CedarGroveStudios/DRV8830_FeatherWing_PCB/README.md

# DRV8830_FeatherWing_PCB

## A custom motor controller and power monitor FeatherWing using the DRV8830 motor controller and INA260 or INA271 power monitor.

[DRV8830 CircuitPython Driver Class Description](https://github.com/CedarGroveStudios/DRV8830_FeatherWing_PCB/blob/main/docs/pseudo%20readthedocs%20cedargrove_drv8830.pdf)

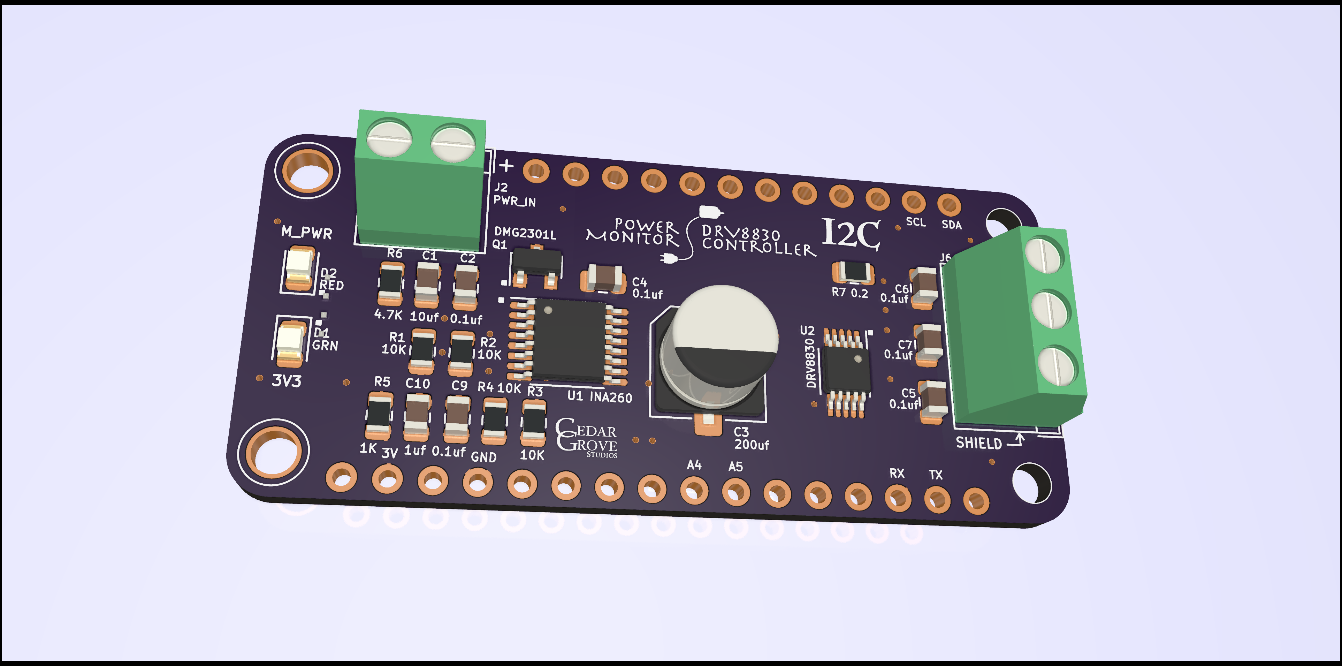
[picture p1: pcb_ina260/Motor_Tester_DRV8830_Wing_glam.png]
DRV8830 FeatherWing INA260


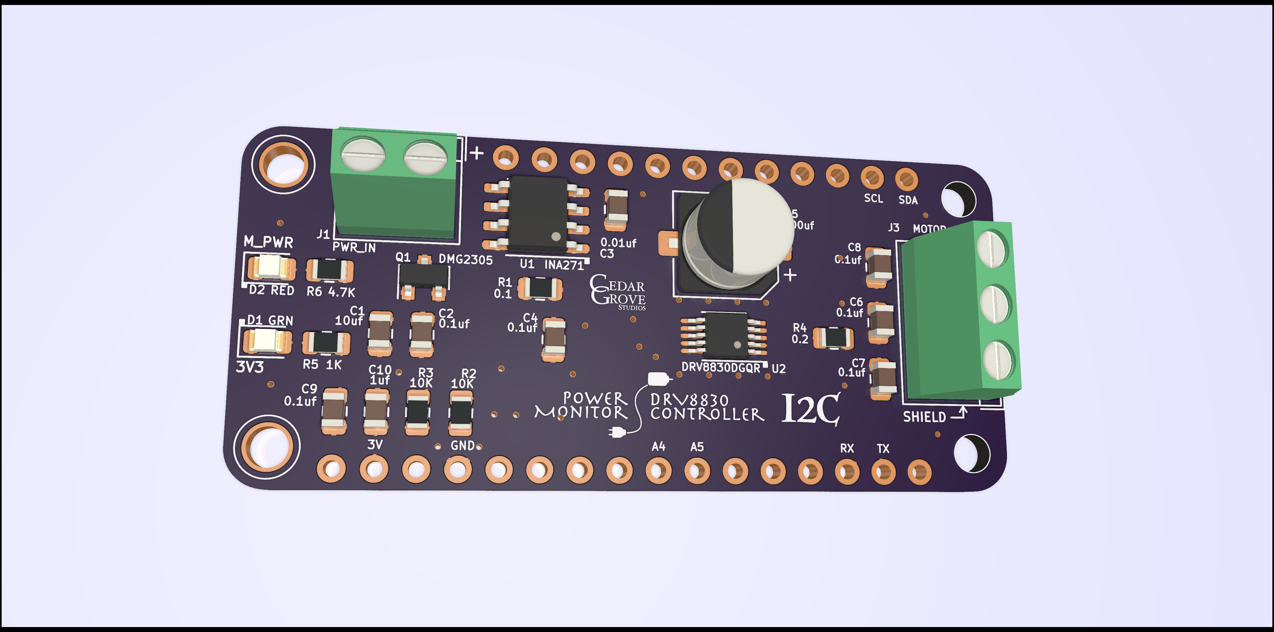
[picture p2: pcb_ina271/Motor_Tester_DRV8830_Wing_glam.png]
DRV8830 FeatherWing INA271
