CedarGroveStudios/DRV8830_FeatherWing_PCB/docs/pseudo_readthedocs_cedargrove_drv8830.pdf

## cedargrove_drv8830

A CircuitPython class for operating the Cedar Grove DRV8830 I2C Motor Controller FeatherWing.

The Cedar Grove DRV8830 FeatherWing is a custom board that integrates the DRV8830 I2C motor controller with an INA260 power monitor. The FeatherWing was designed for use by a DC motor testing apparatus, providing both motor control and the ability to measure motor power. The FeatherWing also provides a connection for an external RPM sensor.

- Author(s): JG for Cedar Grove Studios

## Implementation Notes

### Hardware: Software and Dependencies:

- Adafruit CircuitPython firmware for the supported boards: https://github.com/adafruit/circuitpython/releases

Class representing the Cedar Grove DRV8830, a DC motor driver with I2C interface. Using an internal PWM scheme, the DRV8830 produces a regulated output voltage from a normalized input value (-1.0 to +1.0) or voltage input value (-5.06 to +5.06 volts).

A class property.

A class property.

class cedargrove_drv8830.DRV8830(*, i2c_bus, address=0x2A)

Parameters: | • | i2c_bus – The I2C data and clock bus signals as defined in the host device’s board definition. Typical value is board.I2C() . No default value.
- address – The I2C bus address. Defaults to 0x2A (d42).

throttle

Parameters: | value – Change or read the numeric value of the motor speed, ranging from -1.0 (full speed reverse) to +1.0 (full speed forward), or None (controller off). If None, the H- bridge is set to high-impedance (coasting). If 0.0, the H-bridge is set to cause braking.

throttle_volts

Parameters: | value – Change or read the numeric value of the motor speed, ranging from -5.06 volts (full speed reverse) to +5.06 volts (full speed forward), or None (controller off). If None, the H-bridge is set to high-impedance (coasting). If 0.0, the H-bridge is set to cause braking.

© Copyright 2021 Cedar Grove Studios, Revision 0.1

A class property.

A class property.

Clears all fault condition flags.

bridge_control

Parameters: | (Read-Only) Motor driver bridge status. Returns the 2-bit bridge control integer value
and corresponding description string:
0b00 | STANDBY / COAST
0b01 | FORWARD
0b10 | REVERSE
0b11 | BRAKE

fault

Parameters: | (Read-Only) Motor driver fault register status. Returns state of FAULT flag and a list of
activated fault flag descriptors. FAULT flag is True if one or more fault register flags are True.

Fault Register Flag Descriptors
FAULT | Any fault condition
OCP | Overcurrent event;
device disabled, clear fault to reactivate
UVLO Undervoltage lockout;
device disabled, resumes with voltage restoration OTS Overtemperature condition;
device disabled, resumes with lower temperature ILIMIT Extended current limit event;
device disabled, clear fault to reactivate

clear_faults()

© Copyright 2021 Cedar Grove Studios, Revision 0.1
