CedarGroveStudios/DRV8830_FeatherWing_PCB/graphics/Screen Shot 2021-08-04 at 10.29.17 AM.png

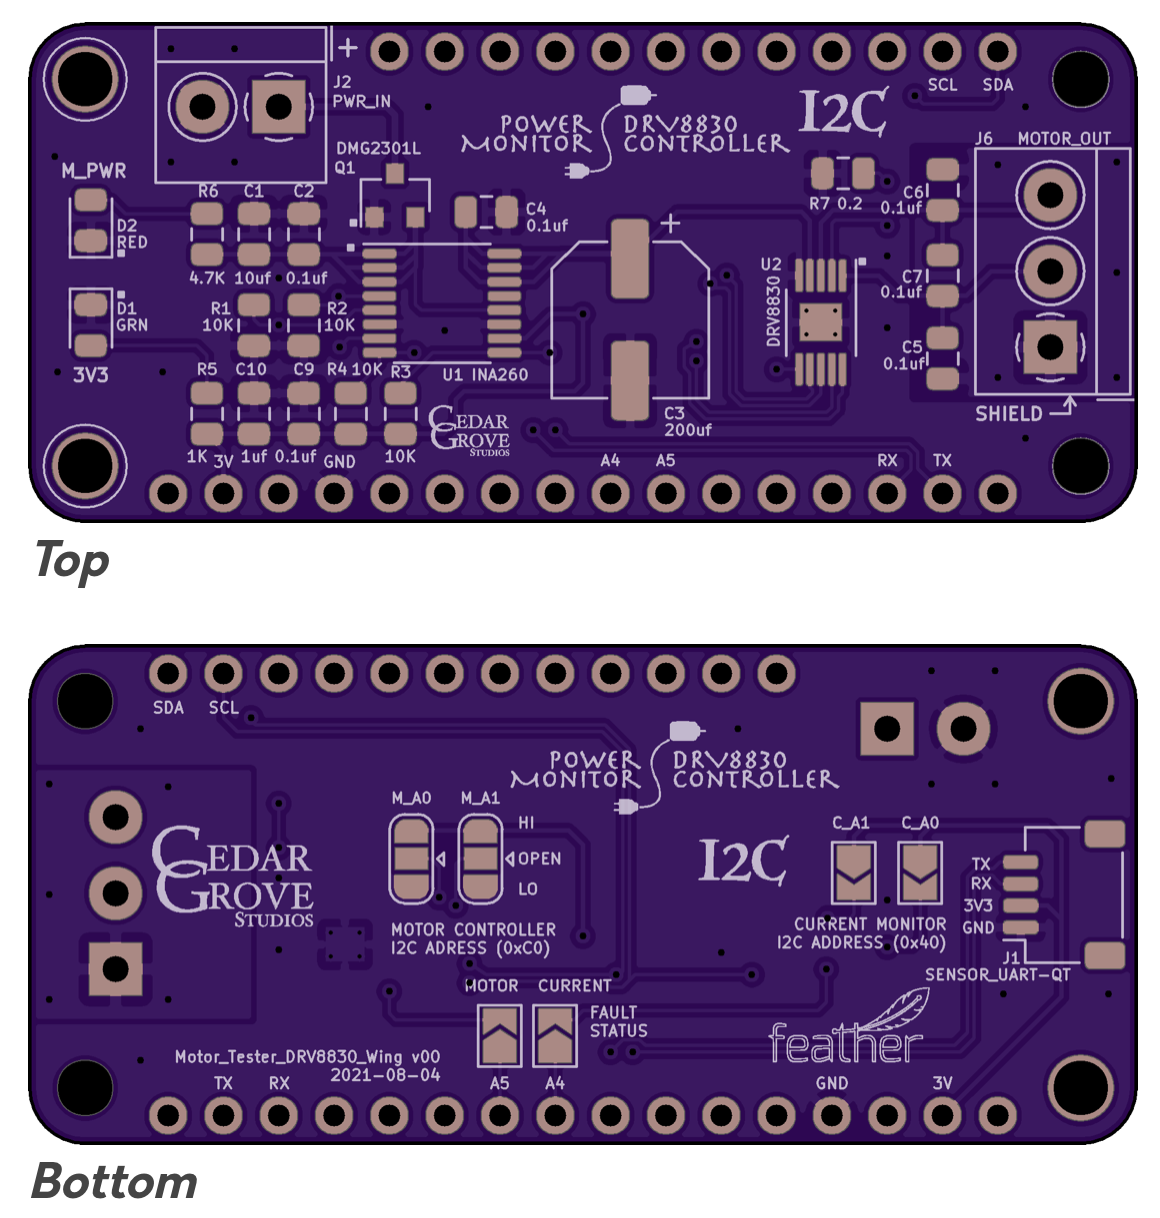
graphics/Screen Shot 2021-08-04 at 10.29.17 AM.png
