CedarGroveStudios/DRV8830_FeatherWing_PCB/media/IMG_0755.jpeg

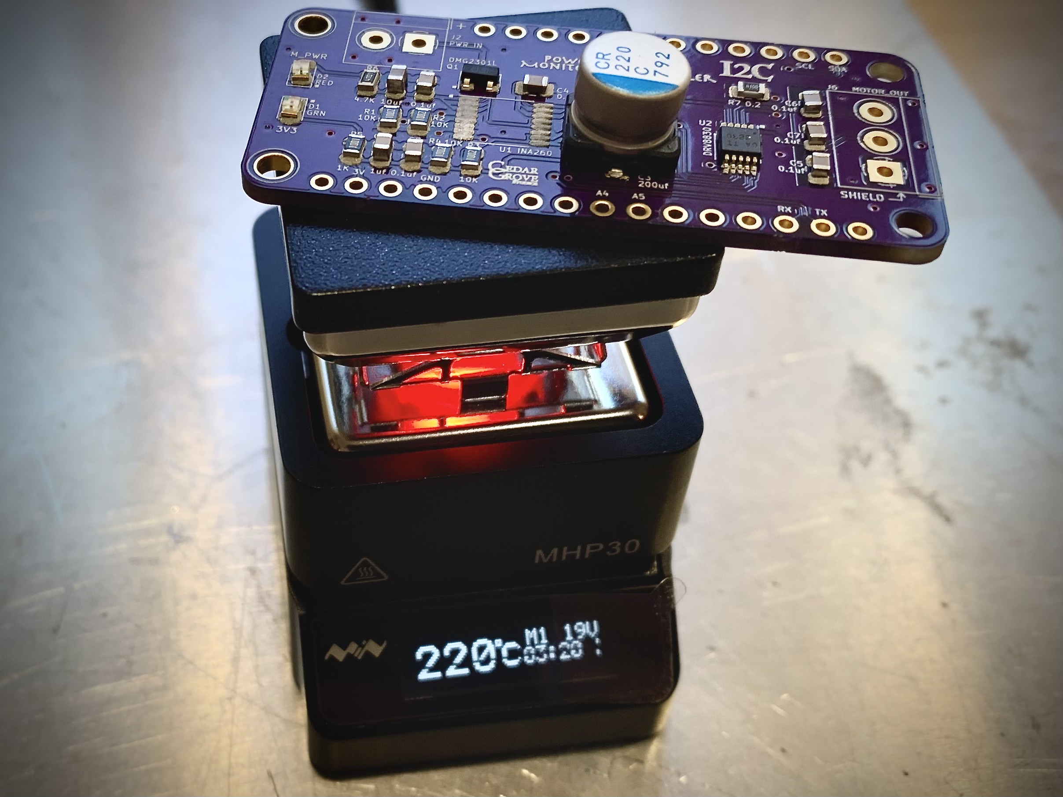
media/IMG_0755.jpeg
