CedarGroveStudios/DRV8830_FeatherWing_PCB/media/IMG_0756.jpeg

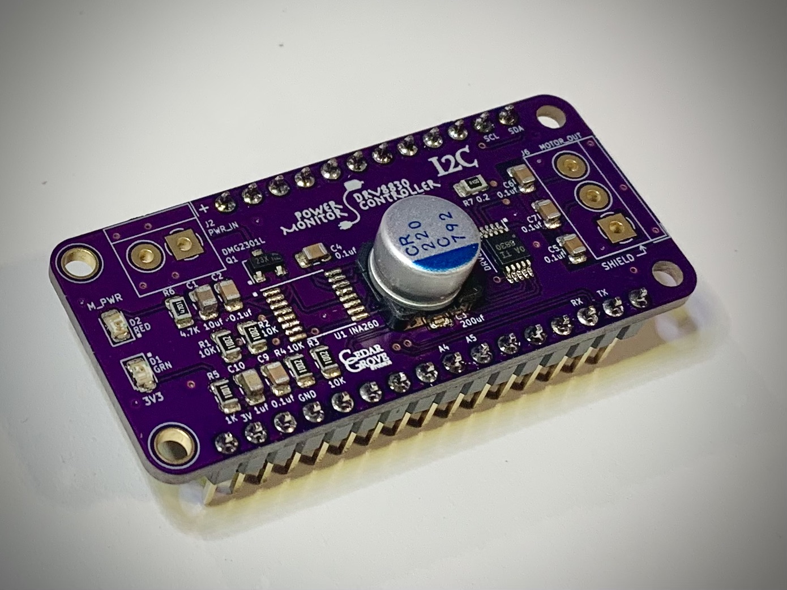
media/IMG_0756.jpeg
