CedarGroveStudios/DRV8830_FeatherWing_PCB/pcb_ina260/Motor_Tester_DRV8830_Wing.png

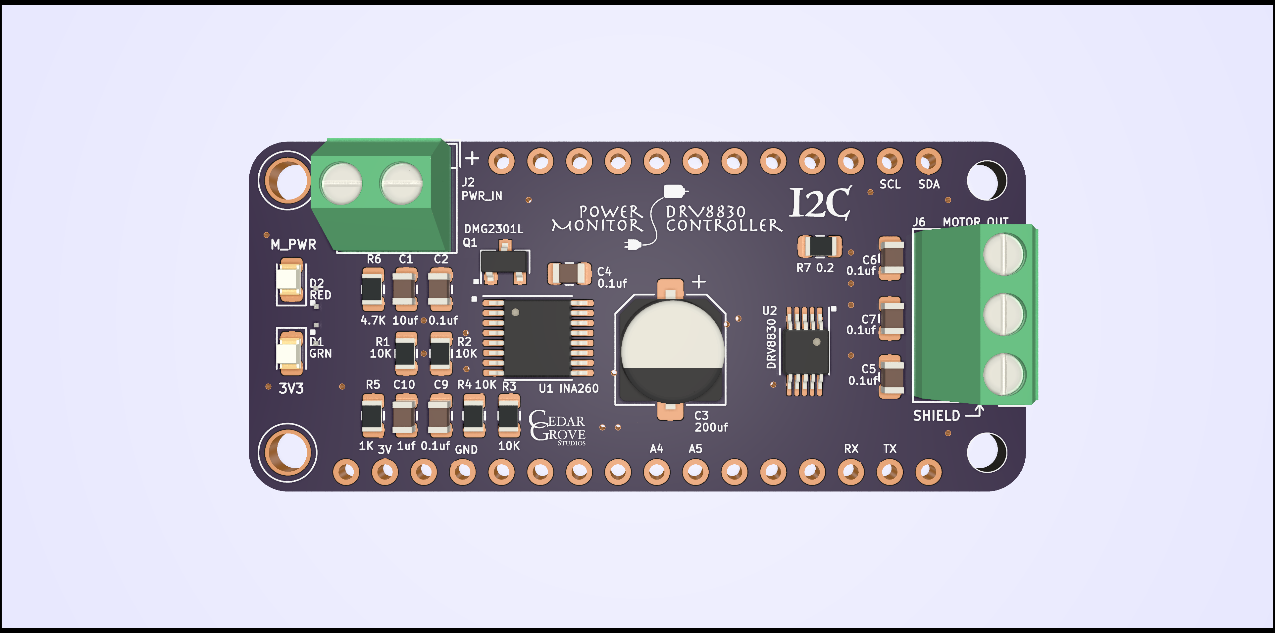
pcb_ina260/Motor_Tester_DRV8830_Wing.png
