CedarGroveStudios/DRV8830_FeatherWing_PCB/pcb_ina260/Motor_Tester_DRV8830_Wing_bot.png

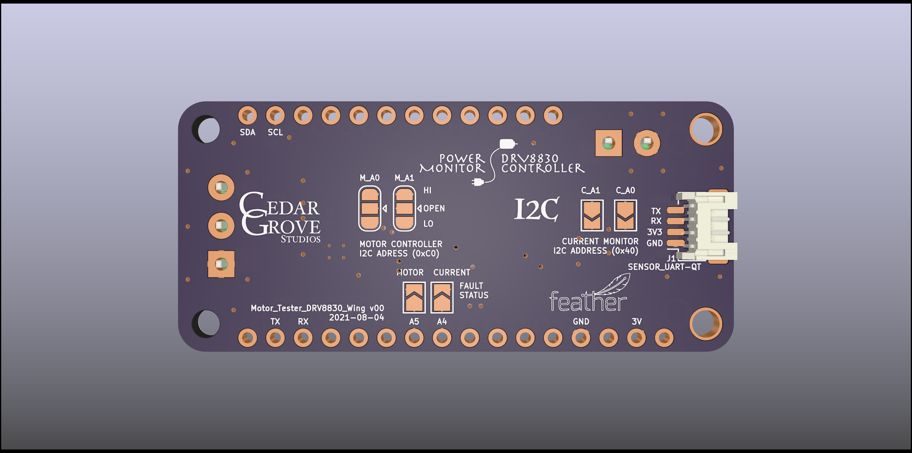
pcb_ina260/Motor_Tester_DRV8830_Wing_bot.png
