CedarGroveStudios/DRV8830_FeatherWing_PCB/pcb_ina271/Motor_Tester_DRV8830_Wing_bot.png

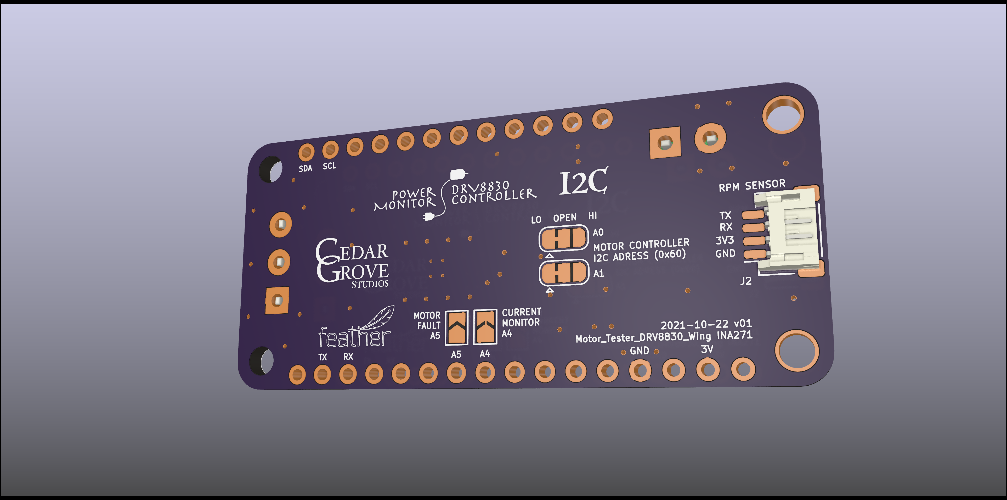
pcb_ina271/Motor_Tester_DRV8830_Wing_bot.png
