CedarGroveStudios/DRV8830_FeatherWing_PCB/(threads)

Thread 1 (2024-03-27):

Is this being manufactured?

psitem, 2024-03-27:
I'd like to buy a few of these boards. Is anyone making / selling them?

CedarGroveStudios, 2024-03-29:
Not that I know of. I used OSHPark.com to make the component-less PCB from the Gerber files then assembled them myself.
