CedarGroveStudios/DRV8830_FeatherWing_PCB/pcb_ina260/Motor_Tester_DRV8830_Wing.pdf

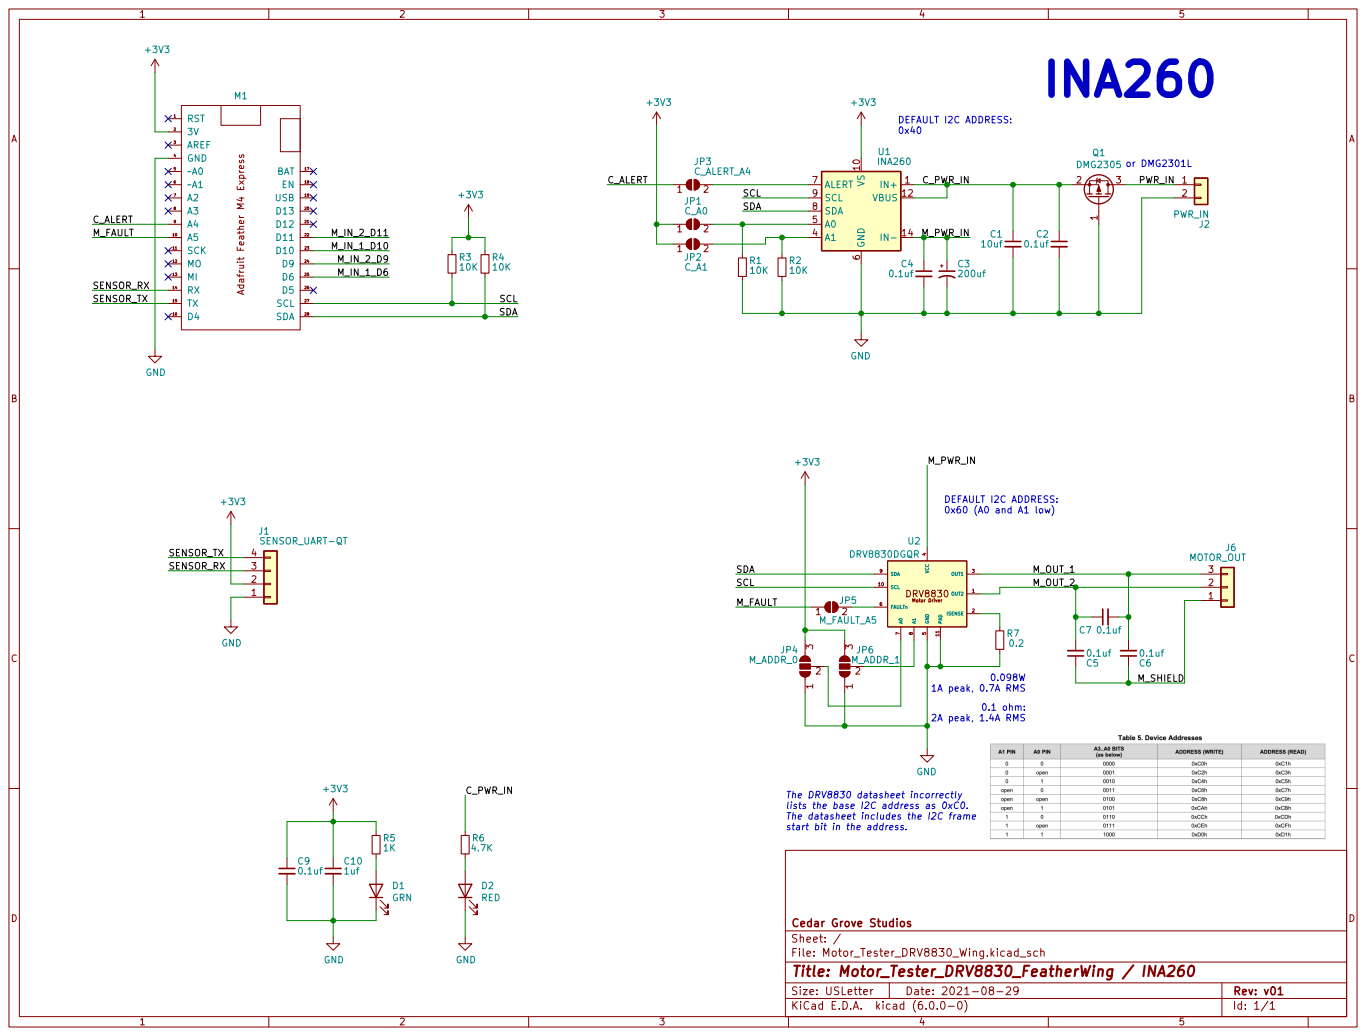
[picture p9: page 1]

The DRV8830 datasheet incorrectly
lists the base I2C address as 0xC0. The datasheet includes the I2C frame

File: Motor_Tester_DRV8830_Wing.kicad_sch Sheet: / Cedar Grove Studios
