CedarGroveStudios/DRV8830_FeatherWing_PCB/pcb_ina271/Motor_Tester_DRV8830_Wing.pdf

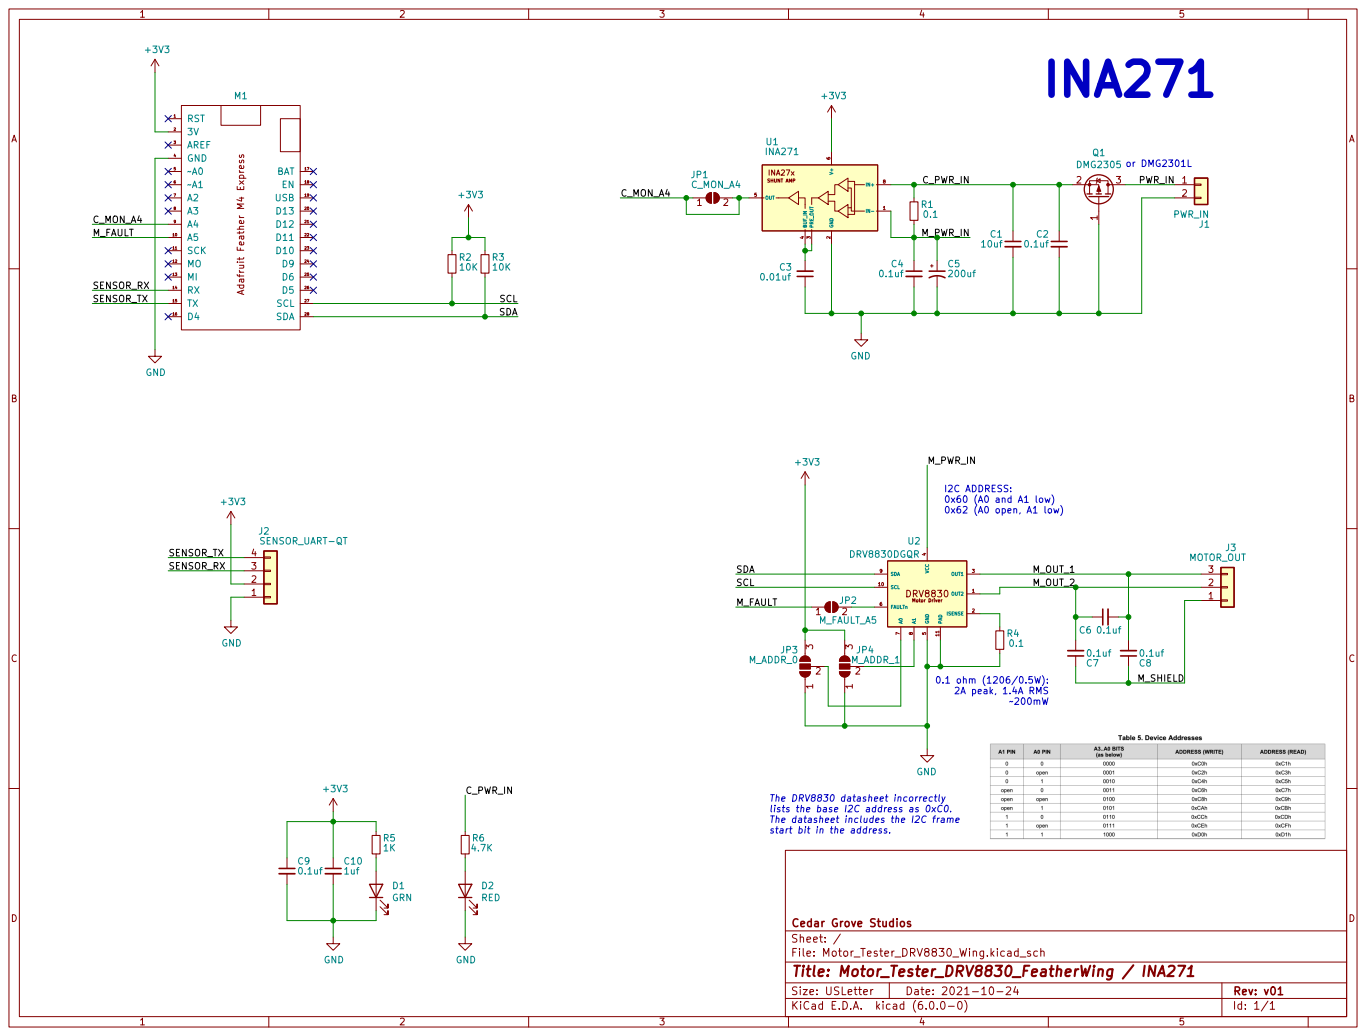
[picture p10: page 1]

File: Motor_Tester_DRV8830_Wing.kicad_sch Sheet: / Cedar Grove Studios GND

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

start bit in the address.
