CedarGroveStudios/DRV8830_FeatherWing_PCB/pcb_ina260/Motor_Tester_DRV8830_Wing.kicad_pcb

## KiCad design pcb_ina260/Motor_Tester_DRV8830_Wing.kicad_pcb (2022-04-24)

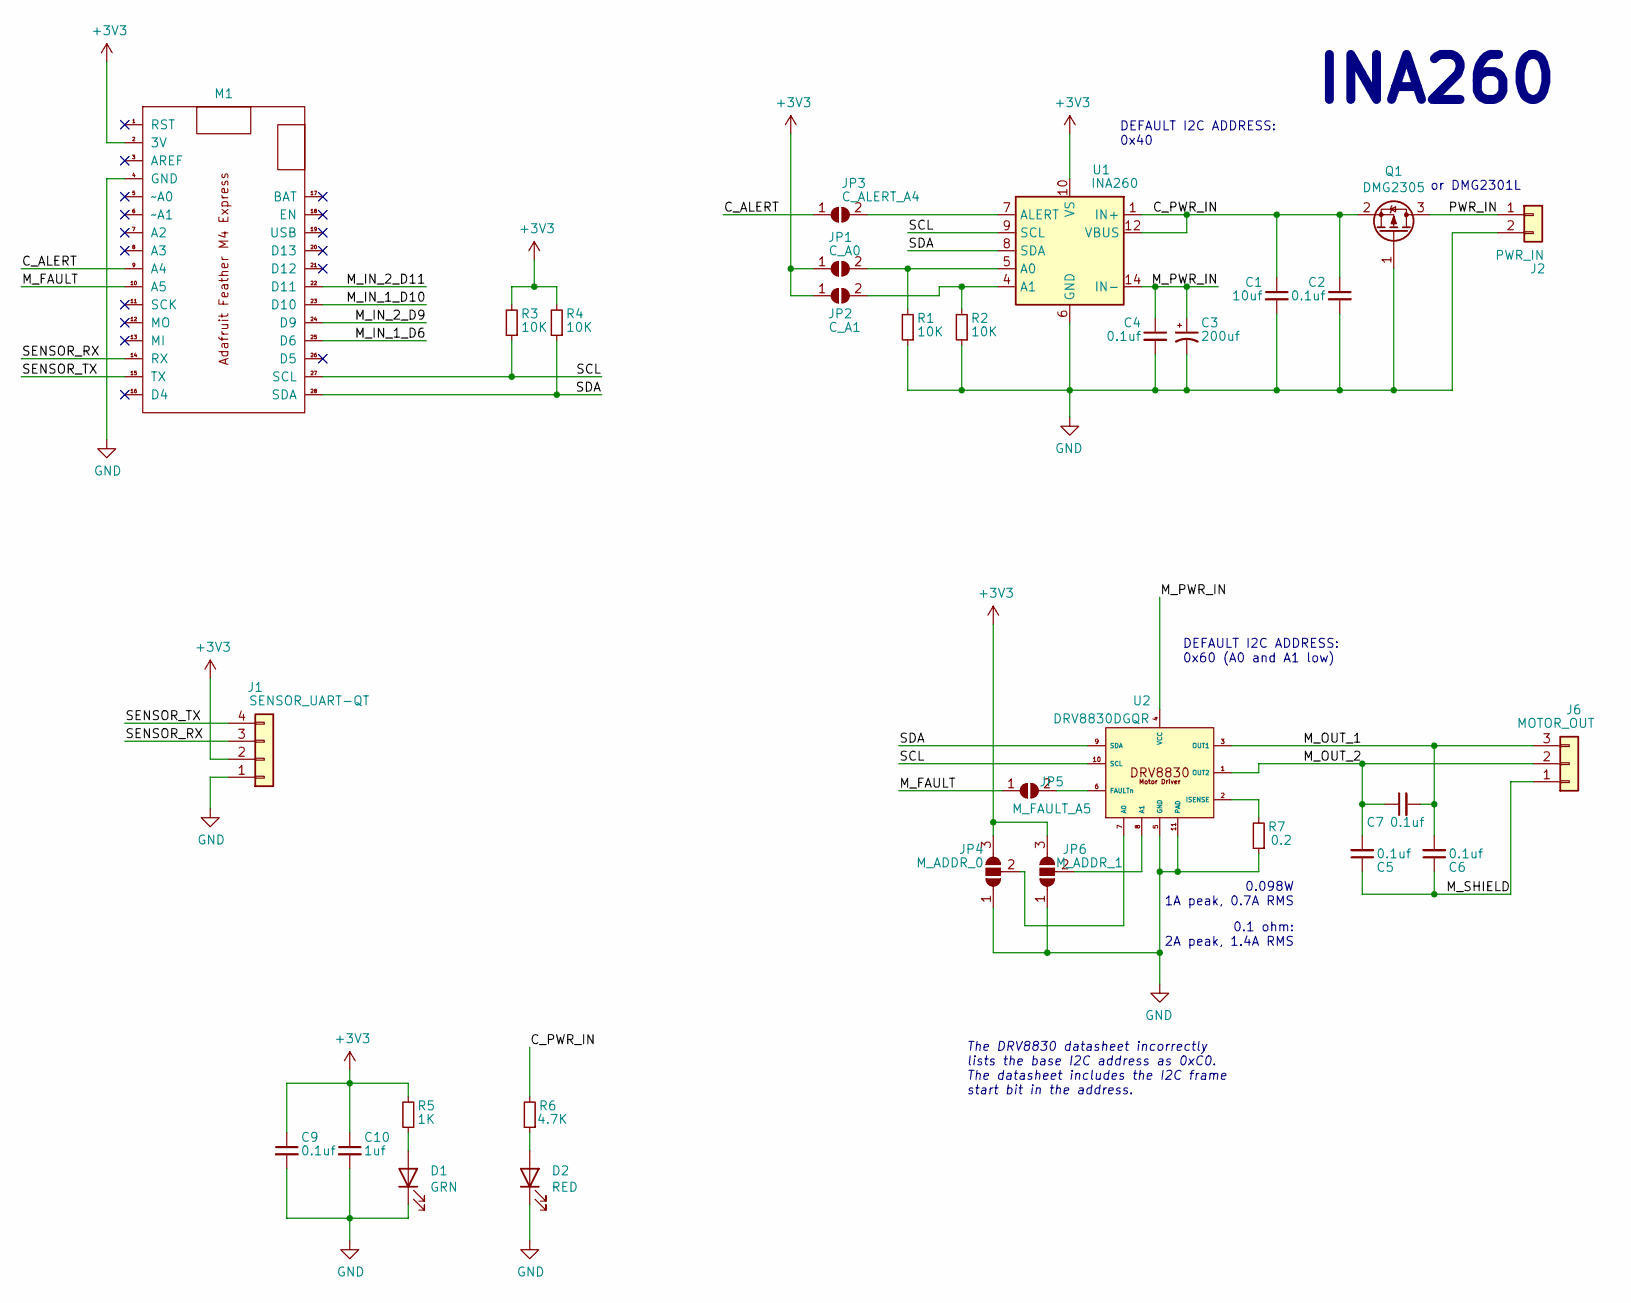
[picture p11: schematic Motor_Tester_DRV8830_Wing.kicad_sch, Motor_Tester_DRV8830_FeatherWing / INA260]

Parts:
C1: 10uf; C_0805_2012Metric
C2, C4, C5, C6, C7, C9: 0.1uf; C_0805_2012Metric
C3: 200uf; CP_Elec_6.6x6.6
C10: 1uf; C_0805_2012Metric
D1: GRN; LED_0805_2012Metric
D2: RED; LED_0805_2012Metric
J1: SENSOR_UART-QT; JST_SH_SM04B-SRSS-TB_1x04-1MP_P1.00mm_Horizontal
J2: PWR_IN; TerminalBlock_4Ucon_1x02_P3.50mm_Horizontal
J6: MOTOR_OUT; TerminalBlock_4Ucon_1x03_P3.50mm_Horizontal
JP1: C_A0; SolderJumper-2_P1.3mm_Open_TrianglePad1.0x1.5mm
JP2: C_A1; SolderJumper-2_P1.3mm_Open_TrianglePad1.0x1.5mm
JP3: C_ALERT_A4; SolderJumper-2_P1.3mm_Open_TrianglePad1.0x1.5mm
JP4: M_ADDR_0; SolderJumper-3_P1.3mm_Open_RoundedPad1.0x1.5mm
JP5: M_FAULT_A5; SolderJumper-2_P1.3mm_Open_TrianglePad1.0x1.5mm
JP6: M_ADDR_1; SolderJumper-3_P1.3mm_Open_RoundedPad1.0x1.5mm
M1: Feather_M4_Express; Adafruit_Feather_M4_Express_bare
Q1: DMG2305; SOT-23
R1, R2, R3, R4: 10K; R_0805_2012Metric
R5: 1K; R_0805_2012Metric
R6: 4.7K; R_0805_2012Metric
R7: 0.2; R_0805_2012Metric
U1: INA260; TSSOP-16_4.4x5mm_P0.65mm
U2: DRV8830DGQR; MSOP-10-1EP_3x3mm_P0.5mm_EP1.68x1.88mm_ThermalVias

Connections:
+3V3: C9.1, C10.1, J1.2, JP1.1 (A), JP2.1 (A), JP4.3 (B), JP6.3 (B), M1.2 (3V), R3.2, R4.2, R5.2, U1.10 (VS)
/C_ALERT: JP3.1 (A), M1.9 (A4)
/C_PWR_IN: C1.1, C2.1, Q1.2 (S), R6.2, U1.1 (IN+), U1.2 (IN+), U1.3 (IN+), U1.12 (VBUS)
/M_FAULT: JP5.1 (A), M1.10 (A5)
/M_IN_1_D6: M1.25 (D6)
/M_IN_1_D10: M1.23 (D10)
/M_IN_2_D9: M1.24 (D9)
/M_IN_2_D11: M1.22 (D11)
/M_OUT_1: C6.2, C7.2, J6.3, U2.3 (OUT1)
/M_OUT_2: C5.2, C7.1, J6.2, U2.1 (OUT2)
/M_PWR_IN: C3.1, C4.1, U1.14 (IN-), U1.15 (IN-), U1.16 (IN-), U2.4 (VCC)
/M_SHIELD: C5.1, C6.1, J6.1
/PWR_IN: J2.1, Q1.3 (D)
/SCL: M1.27 (SCL), R3.1, U1.9 (SCL), U2.10 (SCL)
/SDA: M1.28 (SDA), R4.1, U1.8 (SDA), U2.9 (SDA)
/SENSOR_RX: J1.3, M1.14 (RX)
/SENSOR_TX: J1.4, M1.15 (TX)
GND: C1.2, C2.2, C3.2, C4.2, C9.2, C10.2, D1.1 (K), D2.1 (K), J1.1, J2.2, JP4.1 (A), JP6.1 (A), M1.4 (GND), Q1.1 (G), R1.1, R2.1, R7.1, U1.6 (GND), U1.11 (GND), U2.5 (GND), U2.11 (PAD)
unnamed: D1.2 (A), R5.1
unnamed: D2.2 (A), R6.1
unnamed: JP1.2 (B), R1.2, U1.5 (A0)
unnamed: JP2.2 (B), R2.2, U1.4 (A1)
unnamed: JP3.2 (B), U1.7 (ALERT)
unnamed: JP4.2 (C), U2.7 (A0)
unnamed: JP5.2 (B), U2.6 (FAULTn)
unnamed: JP6.2 (C), U2.8 (A1)
unnamed: R7.2, U2.2 (ISENSE)

Notes on the sheet:
0.1 ohm: 2A peak, 1.4A RMS
DEFAULT I2C ADDRESS: 0x40
INA260
DEFAULT I2C ADDRESS: 0x60 (A0 and A1 low)
0.098W 1A peak, 0.7A RMS
or DMG2301L
The DRV8830 datasheet incorrectly lists the base I2C address as 0xC0. The datasheet includes the I2C frame start bit in the address.

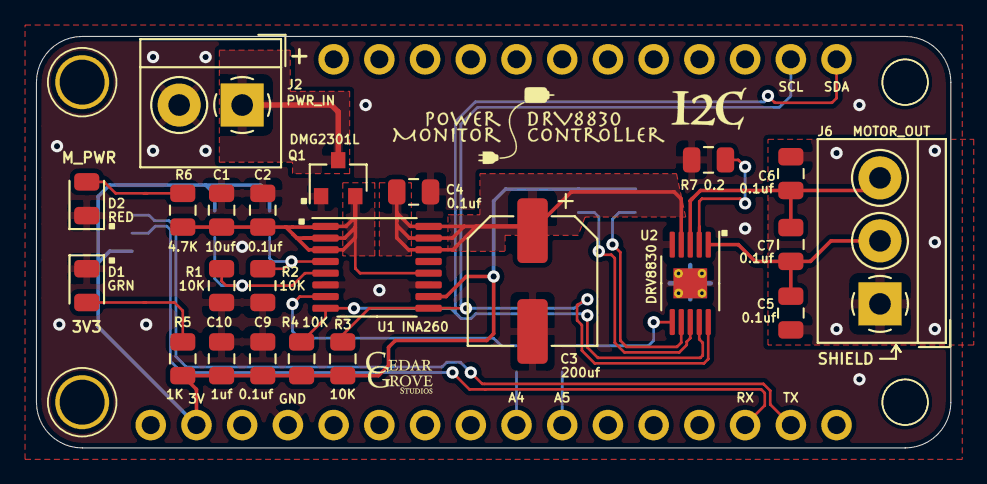
[picture p12: board pcb_ina260/Motor_Tester_DRV8830_Wing.kicad_pcb from above]

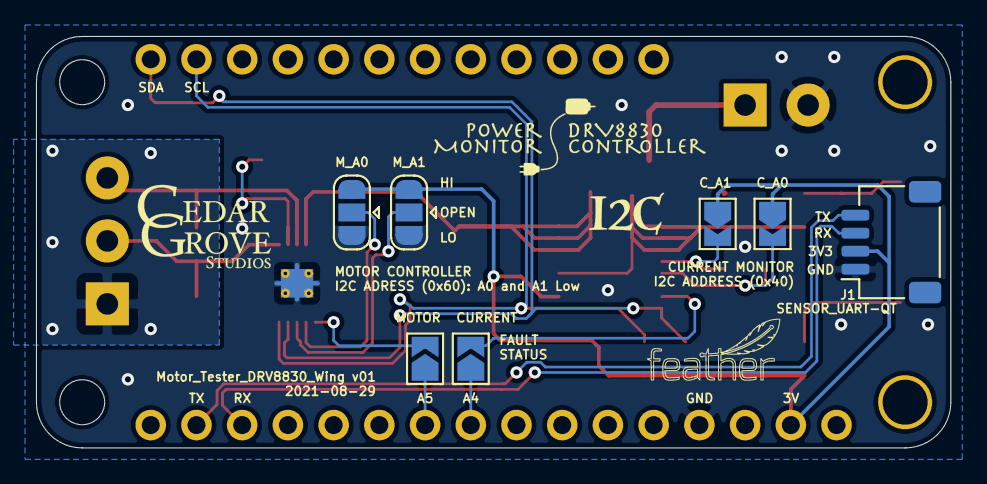
[picture p13: board pcb_ina260/Motor_Tester_DRV8830_Wing.kicad_pcb from below]

Board: 2 copper layers, 50.8 x 22.9 mm, 31 parts (7 on the bottom side), 23 nets.
