CedarGroveStudios/DRV8830_FeatherWing_PCB/pcb_ina271/Motor_Tester_DRV8830_Wing.kicad_pcb

## KiCad design pcb_ina271/Motor_Tester_DRV8830_Wing.kicad_pcb (2022-04-24)

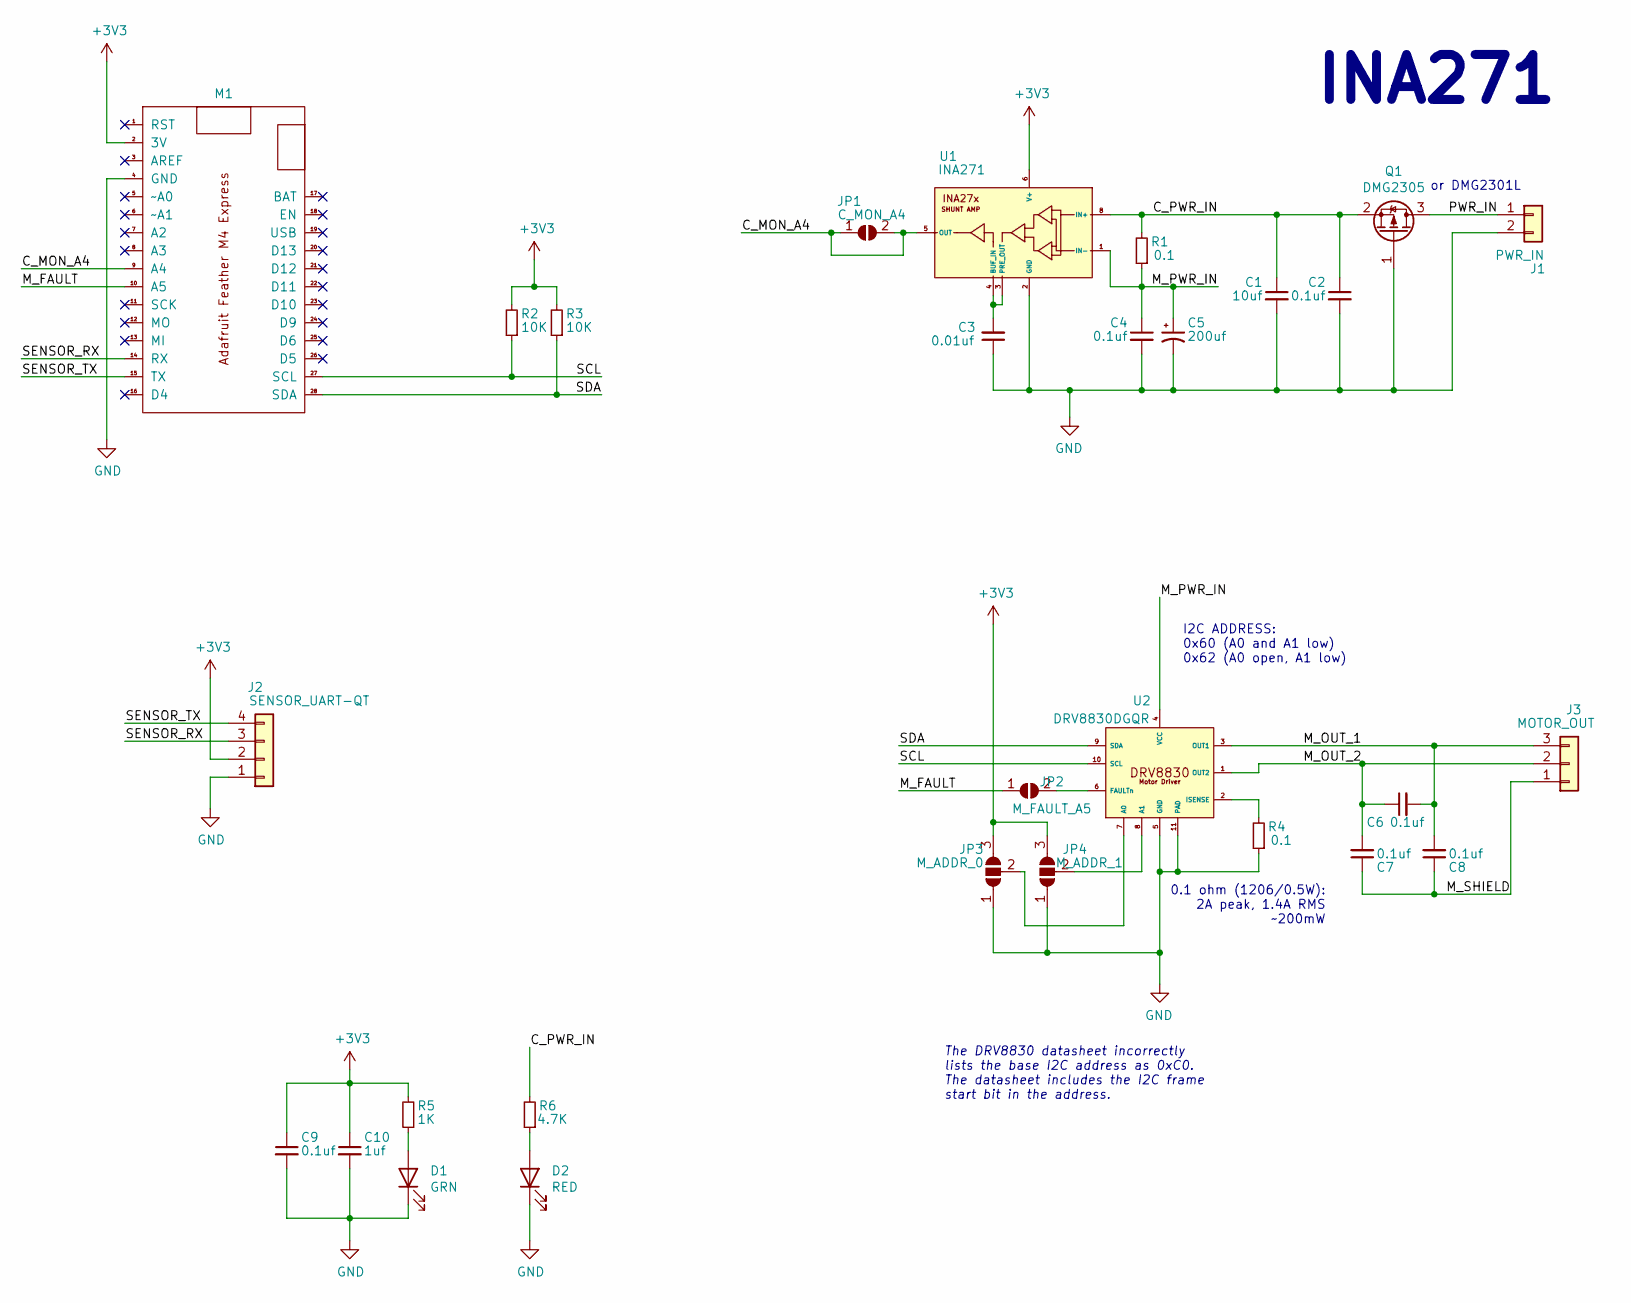
[picture p14: schematic Motor_Tester_DRV8830_Wing.kicad_sch, Motor_Tester_DRV8830_FeatherWing / INA271]

Parts:
C1: 10uf; C_0805_2012Metric
C2, C4, C6, C7, C8, C9: 0.1uf; C_0805_2012Metric
C3: 0.01uf; C_0805_2012Metric
C5: 200uf; CP_Elec_6.6x6.6
C10: 1uf; C_0805_2012Metric
D1: GRN; LED_0805_2012Metric
D2: RED; LED_0805_2012Metric
J1: PWR_IN; TerminalBlock_4Ucon_1x02_P3.50mm_Horizontal
J2: SENSOR_UART-QT; JST_SH_SM04B-SRSS-TB_1x04-1MP_P1.00mm_Horizontal
J3: MOTOR_OUT; TerminalBlock_4Ucon_1x03_P3.50mm_Horizontal
JP1: C_MON_A4; SolderJumper-2_P1.3mm_Open_TrianglePad1.0x1.5mm
JP2: M_FAULT_A5; SolderJumper-2_P1.3mm_Open_TrianglePad1.0x1.5mm
JP3: M_ADDR_0; SolderJumper-3_P1.3mm_Open_RoundedPad1.0x1.5mm
JP4: M_ADDR_1; SolderJumper-3_P1.3mm_Open_RoundedPad1.0x1.5mm
M1: Feather_M4_Express; Adafruit_Feather_M4_Express_bare
Q1: DMG2305; SOT-23
R1, R4: 0.1; R_1206_3216Metric
R2, R3: 10K; R_0805_2012Metric
R5: 1K; R_0805_2012Metric
R6: 4.7K; R_0805_2012Metric
U1: INA271; SOIC-8_3.9x4.9mm_P1.27mm
U2: DRV8830DGQR; MSOP-10-1EP_3x3mm_P0.5mm_EP1.68x1.88mm_ThermalVias

Connections:
+3V3: C9.1, C10.1, J2.2, JP3.3 (B), JP4.3 (B), M1.2 (3V), R2.2, R3.2, R5.2, U1.6 (V+)
/C_MON_A4: JP1.1 (A), JP1.2 (B), M1.9 (A4), U1.5 (OUT)
/C_PWR_IN: C1.1, C2.1, Q1.2 (S), R1.2, R6.2, U1.8 (IN+)
/M_FAULT: JP2.1 (A), M1.10 (A5)
/M_OUT_1: C6.2, C8.2, J3.3, U2.3 (OUT1)
/M_OUT_2: C6.1, C7.2, J3.2, U2.1 (OUT2)
/M_PWR_IN: C4.1, C5.1, R1.1, U1.1 (IN-), U2.4 (VCC)
/M_SHIELD: C7.1, C8.1, J3.1
/PWR_IN: J1.1, Q1.3 (D)
/SCL: M1.27 (SCL), R2.1, U2.10 (SCL)
/SDA: M1.28 (SDA), R3.1, U2.9 (SDA)
/SENSOR_RX: J2.3, M1.14 (RX)
/SENSOR_TX: J2.4, M1.15 (TX)
GND: C1.2, C2.2, C3.1, C4.2, C5.2, C9.2, C10.2, D1.1 (K), D2.1 (K), J1.2, J2.1, JP3.1 (A), JP4.1 (A), M1.4 (GND), Q1.1 (G), R4.1, U1.2 (GND), U2.5 (GND), U2.11 (PAD)
unnamed: C3.2, U1.3 (PRE_OUT), U1.4 (BUF_IN)
unnamed: D1.2 (A), R5.1
unnamed: D2.2 (A), R6.1
unnamed: JP2.2 (B), U2.6 (FAULTn)
unnamed: JP3.2 (C), U2.7 (A0)
unnamed: JP4.2 (C), U2.8 (A1)
unnamed: R4.2, U2.2 (ISENSE)

Notes on the sheet:
The DRV8830 datasheet incorrectly lists the base I2C address as 0xC0. The datasheet includes the I2C frame start bit in the address.
I2C ADDRESS: 0x60 (A0 and A1 low) 0x62 (A0 open, A1 low)
INA271
0.1 ohm (1206/0.5W): 2A peak, 1.4A RMS ~200mW
or DMG2301L

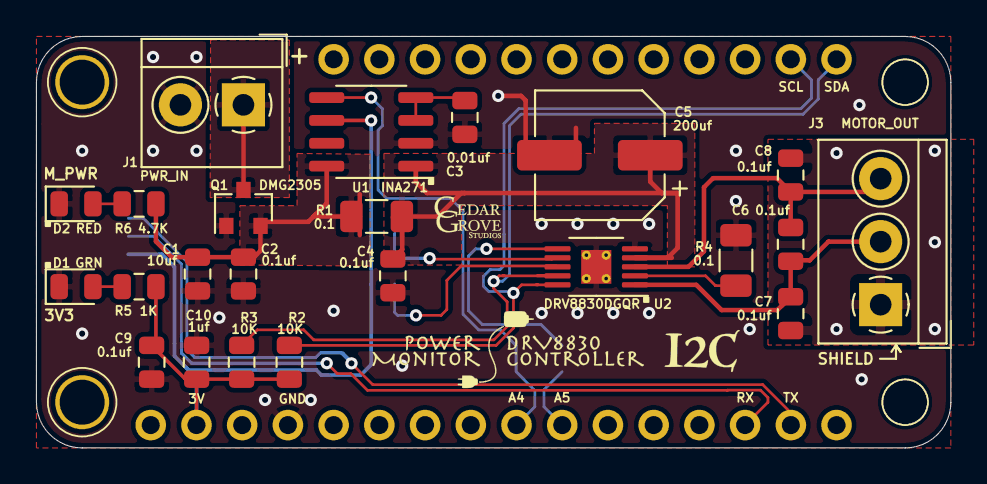
[picture p15: board pcb_ina271/Motor_Tester_DRV8830_Wing.kicad_pcb from above]

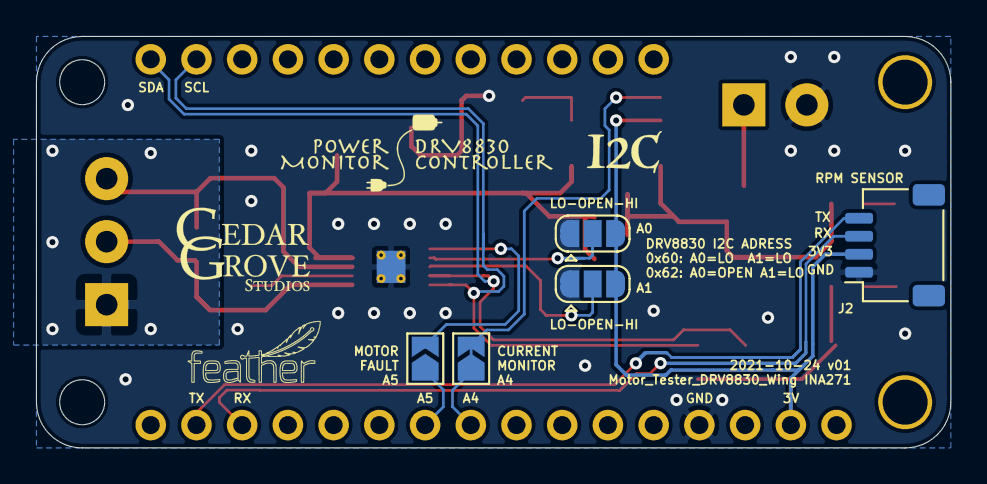
[picture p16: board pcb_ina271/Motor_Tester_DRV8830_Wing.kicad_pcb from below]

Board: 2 copper layers, 50.8 x 22.9 mm, 29 parts (5 on the bottom side), 21 nets.
