CedarGroveStudios/DRV8830_FeatherWing_PCB/code/bundle/MotorKit_PWM_Frequencies.py

pwm_frequencies = [
(  25,  25.0144),
(  26,  25.9724),
(  27,  27.0067),
(  28,  27.9978),
(  29,  29.0644),
(  30,  30.0666),
(  31,  30.9823),
(  32,  31.9556),
(  33,  32.9920),
(  34,  33.9084),
(  35,  35.0777),
(  36,  35.9030),
(  37,  36.9910),
(  38,  37.9100),
(  39,  38.8759),
(  40,  39.8923),
(  41,  40.9632),
(  42,  42.0932),
(  43,  42.9825),
(  44,  43.9102),
(  45,  44.8788),
(  46,  45.8911),
(  47,  46.9501),
(  48,  48.0592),
(  49,  48.8281),
(  50,  50.0288),
(  51,  50.8626),
(  52,  52.1668),
(  53,  53.0740),
(  54,  54.0134),
(  55,  54.9866),
(  56,  55.9955),
(  57,  57.0422),
(  58,  58.1287),
(  59,  59.2574),
(  60,  59.8384),
(  61,  61.0352),
(  62,  62.2808),
(  63,  62.9228),
(  64,  64.2475),
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
]
