CedarGroveStudios/DRV8830_FeatherWing_PCB/code/bundle/Breakout_PWM_Frequencies.py

pwm_frequencies = [
(   1, 1),
(   2, 2),
(   3, 3),
(   4, 4),
(   5, 5),
(   6, 6),
(   7, 7),
(   8, 8),
(   9, 9),
(  10, 10),
(  11, 11),
(  12, 12),
(  13, 13),
(  14, 14),
(  15, 15),
(  20, 20),
(  25, 25),
(  30, 30),
(  40, 40),
(  50, 50),
(  60, 60),
(  70, 70),
(  80, 80),
(  90, 90),
(  100, 100),
(  125, 125),
(  150, 150),
(  175, 175),
(  200, 200),
(  300, 300),
(  400, 400),
(  500, 500),
(  600, 600),
(  700, 700),
(  800, 800),
(  900, 900),
(  1000, 1000),
(  1500, 1500),
(  2000, 2000),
(  2500, 2500),
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
]
