CedarGroveStudios/DRV8830_FeatherWing_PCB/(commit log)

2022-04-24 initial repo load
    [Motor_Tester_DRV8830_Wing-B_Cu.gbr, Motor_Tester_DRV8830_Wing-B_Mask.gbr, Motor_Tester_DRV8830_Wing-B_SilkS.gbr, Motor_Tester_DRV8830_Wing-Edge_Cuts.gbr, Motor_Tester_DRV8830_Wing-F_Cu.gbr, Motor_Tester_DRV8830_Wing-F_Mask.gbr, Motor_Tester_DRV8830_Wing-F_Paste.gbr, Motor_Tester_DRV8830_Wing-F_SilkS.gbr]
2022-04-25 rename old driver class file as "orig"
